JulesCastel/ARISE-Alexithymia/documentation/Boards-info.txt

ESP32-WROOM-32-DevkitV1

MAC address:
8c:4f:00:3c:ec:b0

-----------------------------------------------------------------------------------

ESP32-A1S-AudioKit

MAC address:
34:5f:45:25:20:44
