JulesCastel/ARISE-Alexithymia/documentation/initial-draft-feb-28-2025.pdf

# DUI

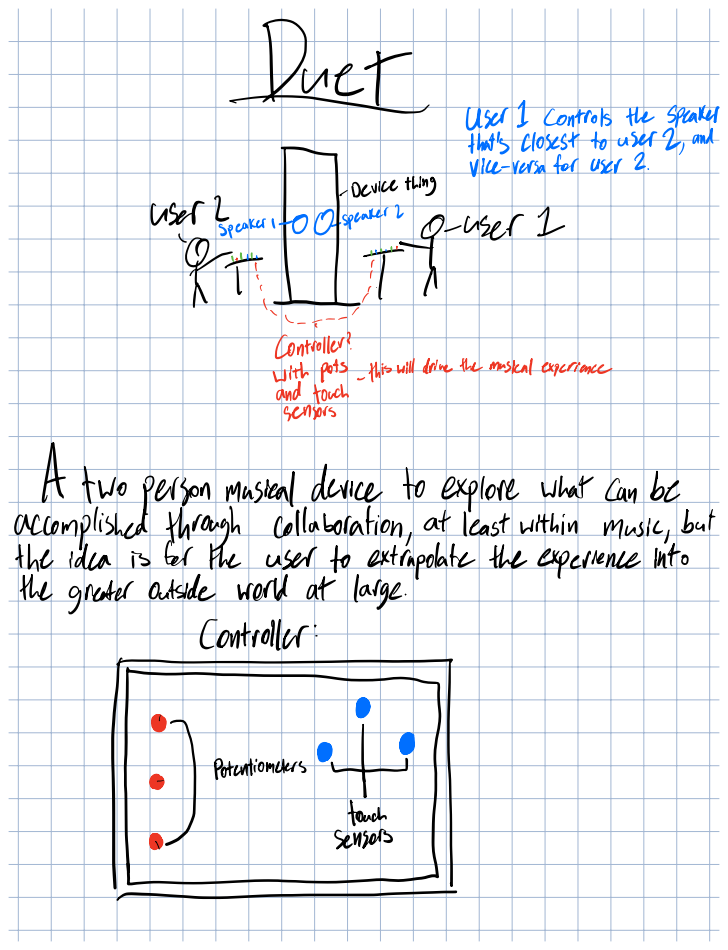
[picture p5: page 1]
that's closest to; user 2 an; user becauseif; thing; Eti; user; A two person; musical device to explore what can be; accomplished; through; collaboration; at least within music; he idea; for the; to extrapolate; the experience into; the greater outside world at; large; comfy; Potentiomers; touch; Sensors

user 1 controls the speaker
vice versa for user 2

Controller
with pots thiswilldrivethemusical experience
and touch
sensors

# ESPIY.ME EYEthI pi

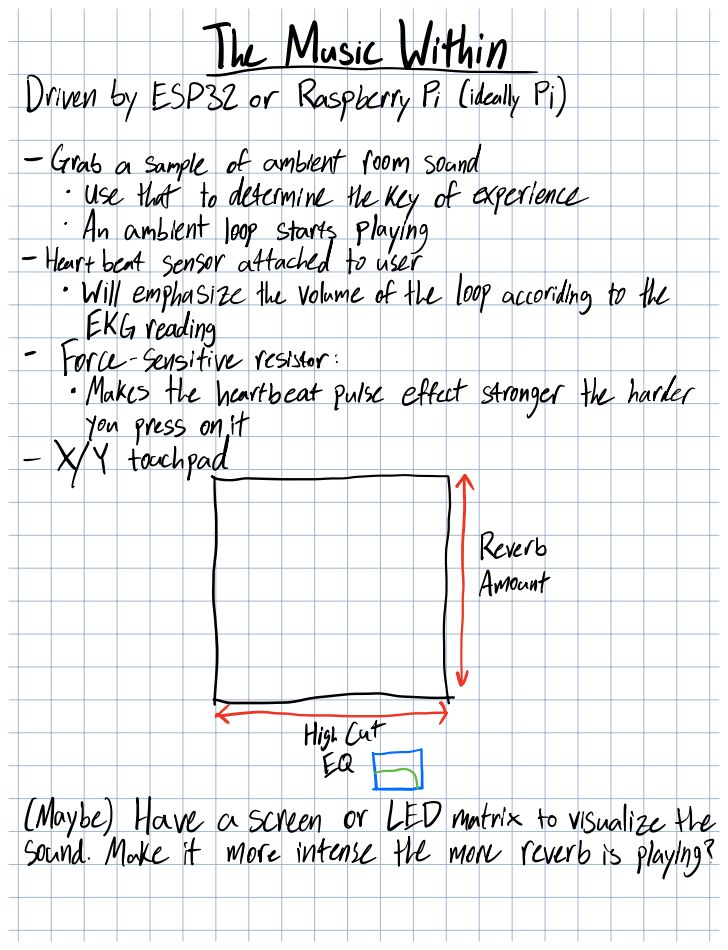
[picture p6: page 2]
Driven by; Grab; a sample; ambient room sound; Use that; to determine thekey of experience; An ambient loop starts; playing; Heartbeat; sensor attached to; user; Will emphasizethe volume of the; loop according to the; Force sensitive; resistor; Makes the heartbeat pulse effect stronger; the harder; Reverb Amount; Maybe; Have; a screen or; LED matrix to visualize the; sound Make; more; intense; the; reverb is playing

EKGreading
you press on it
NY touchpad

# skies

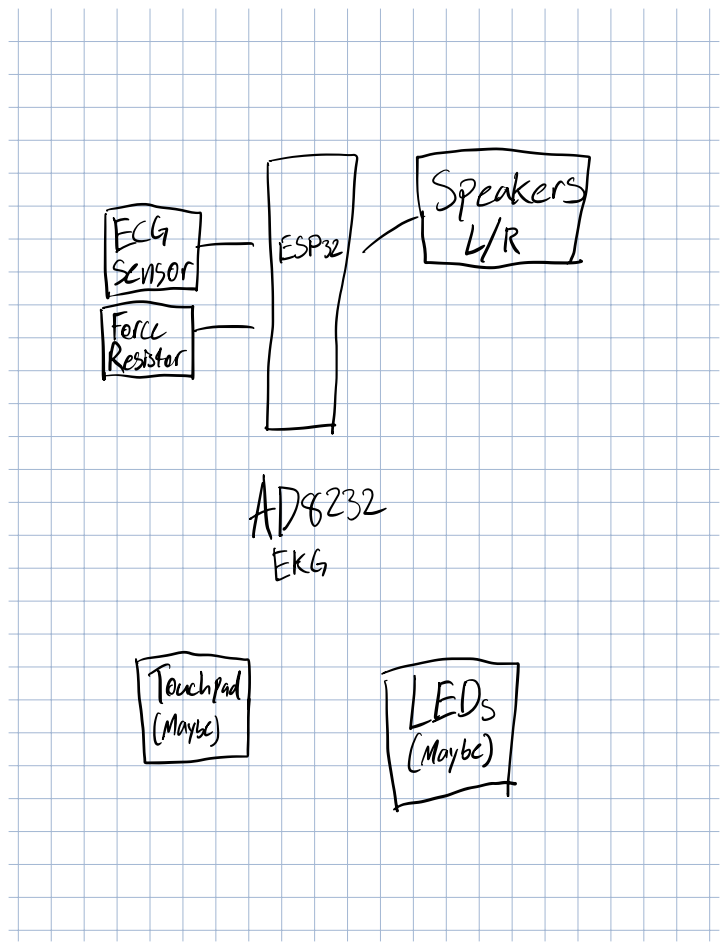
[picture p7: page 3]
EKG; Touchpadh; YEH
