JulesCastel/ARISE-Alexithymia/documentation/roadmap-journal.pdf

# Goal

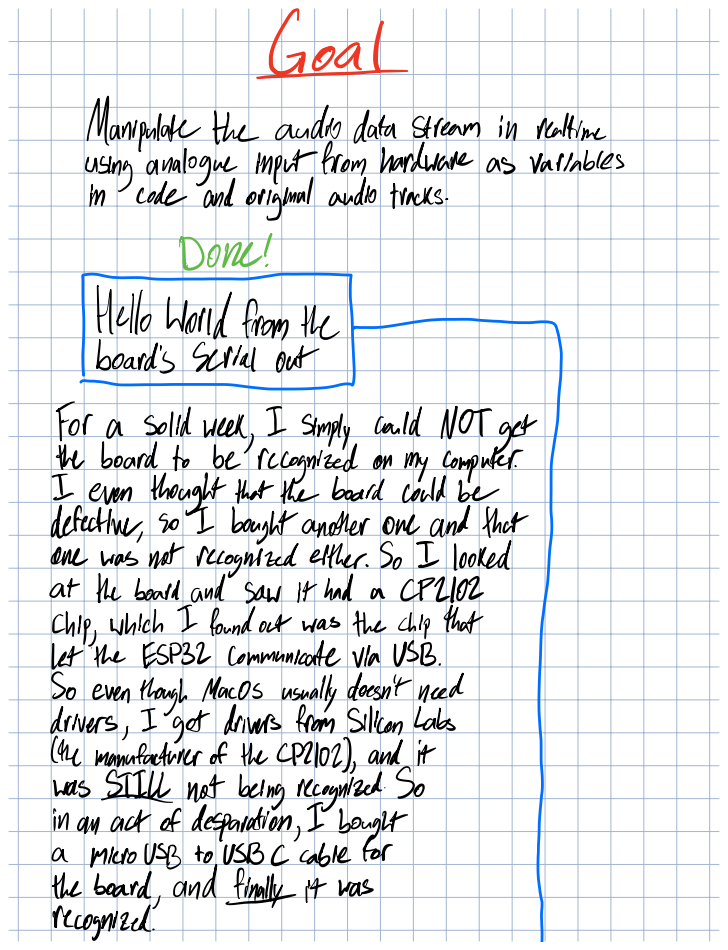
[picture p8: page 1]
using analogue; inputfrom hardware; variables; code and original; audio tracks; HellowordfromD board's; serial out; For a solid week I; simply could NOTget the board to be; recognized on my computer; even thoughtthatthe board could be; defective; boughtanother one and that; one was not recognized either So; looked; the board and saw it had a CP2102; lettheESP32; Communicate via USB; the manufacturerof theCP2102; and; in an act; of desparation I bought; microUSB to USB C cable for

Manipulate the audio data stream in realtime
Done
www.aol

am union and
So eventhough MacOS usually doesn'tneed
drivers I got drivers from Silicon Labs
was STILL not being recognized So
the board andfinally it was
recognized

Donel | boardtothespeakD
This has | been | a | complete nightmare There | is | ZERO

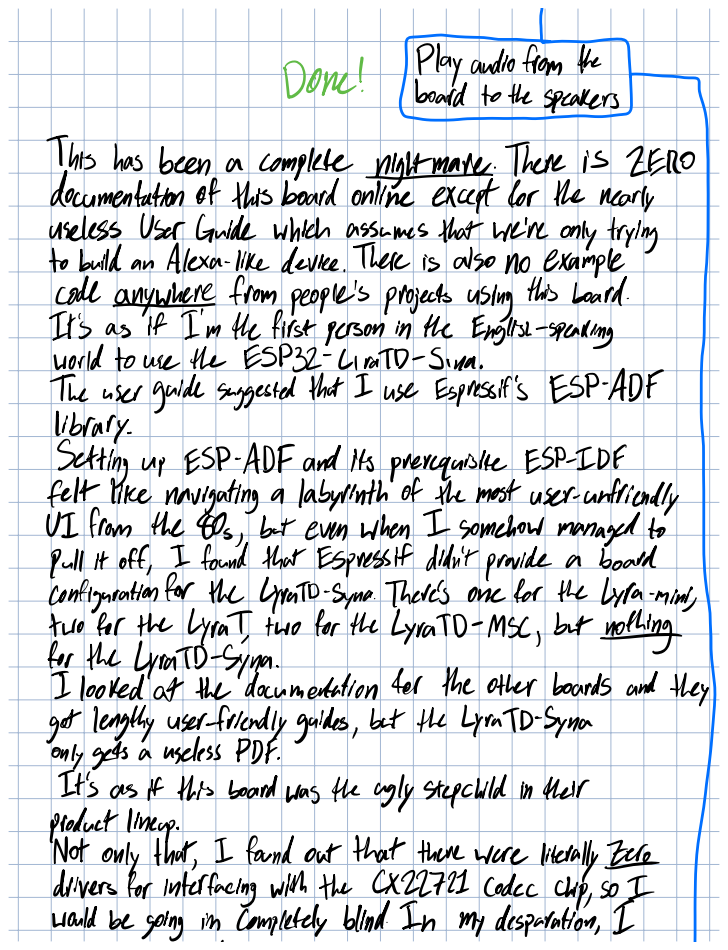
[picture p9: page 2]
Playaudiofrom the; to build an Alexa like device There; also no example; code anywhere from people's; projects using this board; if I'm the firstperson in; the English; speaking; world to use; the ESP32 LiraTD; Sina; The user guide suggested that; use Espressif's; ESPADF; Setting up ESP ADFand its; prerequisite; ESP; IDF; felt like navigating a; labyrinth of the most user unfriendly; UI from; the 80s; but even when; somehow managed to; pull it; off; found that Espress if; didn'tprovide a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

documentation of thisboard online exceptfor the nearly
useless UserGuide which assumes that we're only trying
library

got lengthy user friendlyguides but the LyraTD Syna
It's as if this boardwas the ugly stepchild in their
productlineup

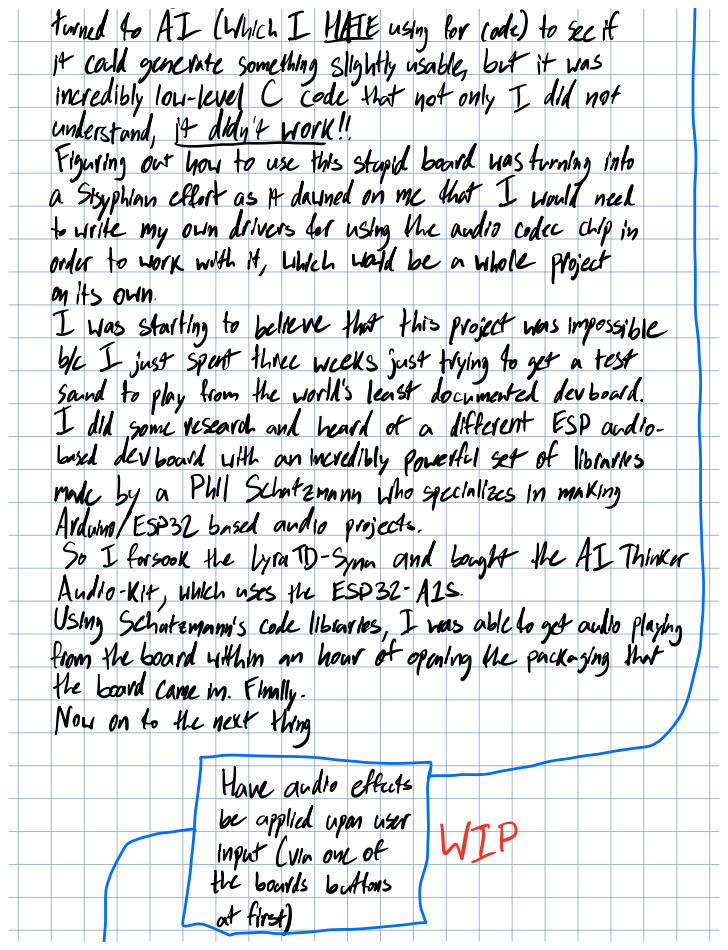
[picture p10: page 3]
Figuring; Toulousethis stupid board wasturning into; a Sisyphian effort as it dawned on me that I; would need; to write my; own drivers for using the audio codec chip in; order to work with it which; would be; a whole; project; was starting; believe that this project was impossible; just spentthree weeks justtrying toget a test; sound; to play from the world's least documented; devboard; did; someresearch and; heard; different; ESP audio; based devboard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

on its own
Arduino ESP32 based audio projects
the board came in Finally
Now on to the next thing

Haveaudio effects
be applied upon user

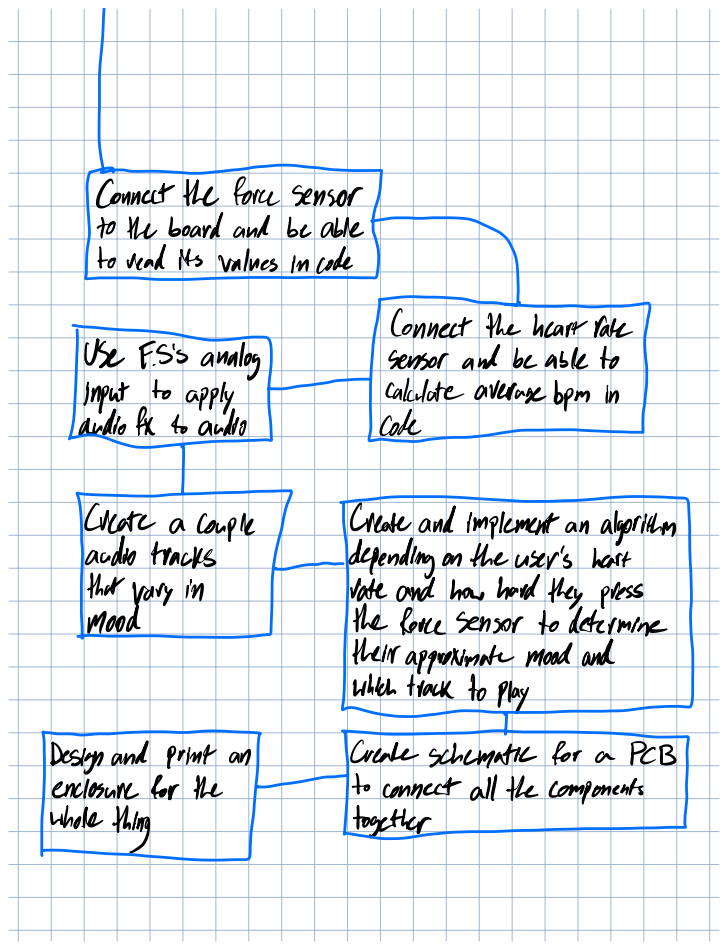
[picture p11: page 4]
to the board and; be able; code; Crateamfaendingontheuserishop; audio tracks; thatvary; rateand how hardthey press; mood; the fore sensor to determine; Designand print an; Create schematic; for a; PCB; emmJe; connectallthecomponent; wholething; together

net the force sensor
toreadmsvaluesmcode.tl

onnect the heartrate
sensor and be able to calculateaverasebpmin

Createand implement an algorithm

theirapproximate moodand
whichtrack to play
