JulesCastel/ARISE-Alexithymia/(commit log)

2025-04-11 Testing sending data from ESP32 to another
2025-04-12 main files for the boards
    from the example code i worked on earlier
2025-05-12 organize files, started the audio section
    moved the code i used to learn libraries to their own folder
    started work on the main audio section now that the sensor data transmission works
2025-05-23 Finishing out the project
    i should've been keeping up with updating the repo oops
    since the last push i have:
    - changed the code styling to my liking (using Allman brace style now)
    - restructured most of loop() into separate functions
    - created the playAudio() function to control playing an audio file and then ending the AudioStream so that the program can continue
    - handle the averages calculation with calculateAverages() and sampleData()
    - created another function for playing the [number].wav files in the right order
    tomorrow is the showcase!! yippee!!!!
